billabongAFS/windlogger_digital/README.md

# windlogger_digital v120 
## ! This is only a copy with notes for futurs improvements !

The windlogger digital board is a arduino like board based on the Atmega 1284p.

This repo is on the version 1.2.0.

Go on the [wiki](https://github.com/netbomo/windlogger_digital/wiki) for more information.

## BLOCK DIAGRAM

todo

## RENDER PREVIEW
todo
