billabongAFS/windlogger_digital/Documents/Notice soudure.odt

Ordre des fonctions à souder :

Feuille Power Supply :

- alim 5 Volt, test avec alim externe DC + voltmètre

- alim 3,3V, test avec alim dc externe + voltmètre, erreur pin du mcp1700 inversé (corrigé sur schéma)

- cablage switch supply (usb to 5V) test avec alim et voltmètre

-soudure module uart, test alim par usb, cable usb to microUSB + voltmètre

Feuille microC

- tout souder sauf micro, tester les alim du micro puis le souder

Feuille digital

tout souder

test chargement bootloader par isp :

Attention, si micro atmega1284 et non atmega1284p, éditer dans arduino-1.6.3/hardware/tools/avr/etc (faire une copie avant)

le ficher : avrdude.conf, éditer la section Atmega1284P (ctrl-f) et changer la signature 0x1e 0x97 0x05; par 0x1e 0x97 0x06;

puis upload firmware test_carte (à faire) la led doit clignoter

Monter carte SHIELD et suivre procédure TEST_CARTE

Monter le module de sortie de son choix plus les compo qui vont avec.

Upload firmware datalogger
