billabongAFS/windlogger_digital/Documents/images/sch_anemo_hall.png

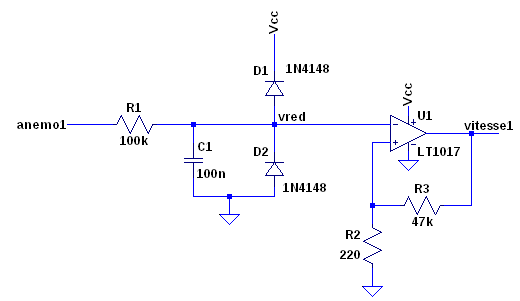
Documents/images/sch_anemo_hall.png
