billabongAFS/windlogger_digital/Documents/images/sch_GPRS.png

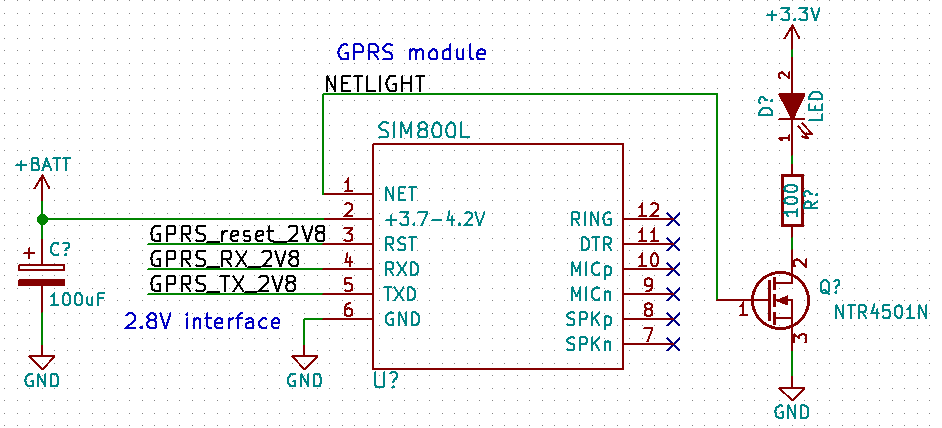
Documents/images/sch_GPRS.png
