billabongAFS/windlogger_digital/Documents/images/sch_huzzah.png

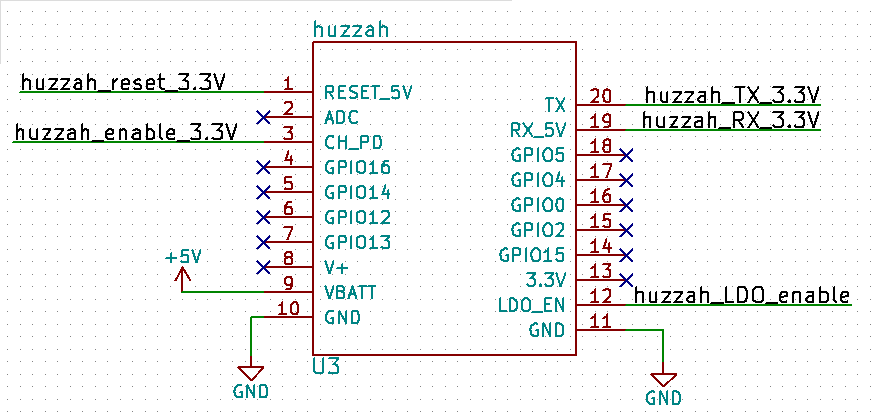
Documents/images/sch_huzzah.png
