billabongAFS/windlogger_digital/Documents/images/sch_RFM69CW.png

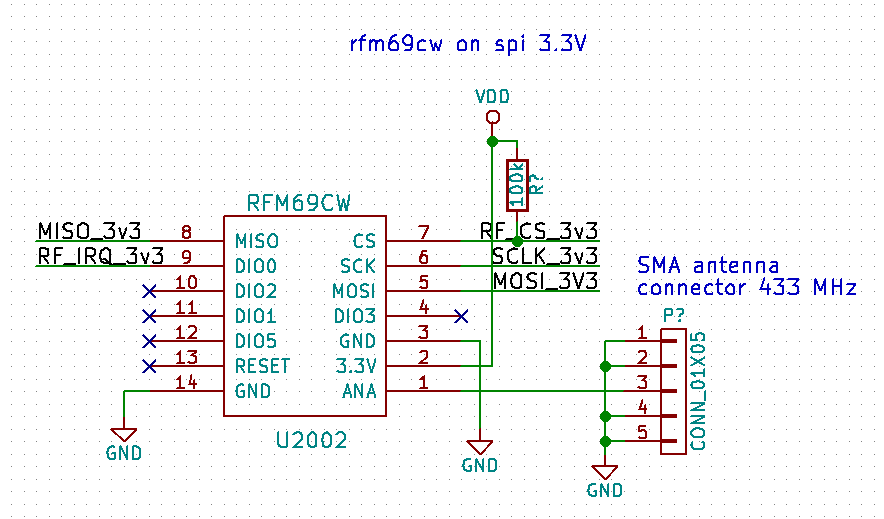
Documents/images/sch_RFM69CW.png
