billabongAFS/windlogger_digital/Documents/images/sch_SD.png

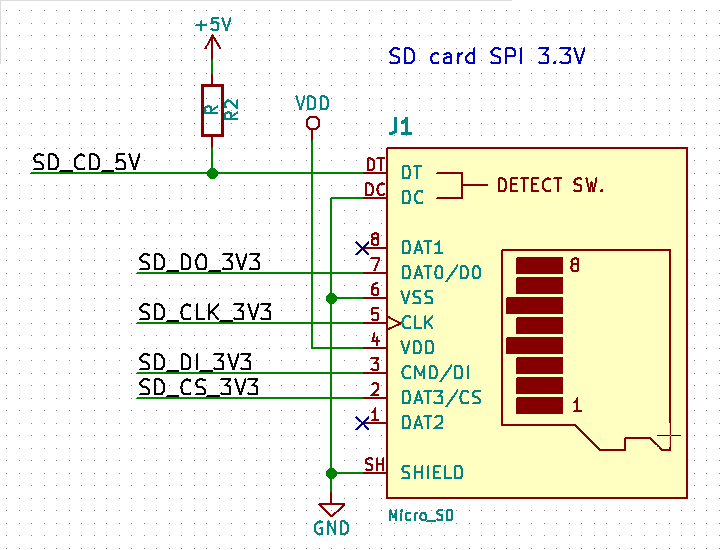
Documents/images/sch_SD.png
