billabongAFS/windlogger_digital/Documents/images/sch_vdc.png

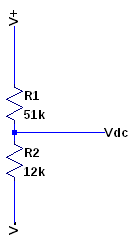
Documents/images/sch_vdc.png
