billabongAFS/windlogger_digital/LTSpice/power_switch.asc

C1: cap; 1µ
M1: pmos; IRF7210
M2: pmos; IRF7210
R1: res; 250
R2: res; 10k
R3: res; 10k
U1: LT1218
V1: voltage; 5
V2: voltage; PULSE(0 5 0 0 0 1 2 5)
V3: voltage; 5
Named nets: 0, cmd, Vbatt, Vmicro, V5V, cmd_inv
.tran 5
