billabongAFS/windlogger_digital/kicad/digital.sch

## KiCad design kicad/digital.sch (2018-02-15)

Schematic: digital.sch

Parts:
Analog1: CONN_01X08; Socket_Strip_Straight_1x08
C1: 100n; C_Rect_L7_W2.5_P5
Communication1: CONN_01X08; Socket_Strip_Straight_1x08
D1: Led_Small; LED-3MM
P1: USART0; uart_usb_cp2102_module
P3: ISP; Socket_Strip_Straight_2x03
P5, P6, P8, P9: hole; MountingHole_3-5mm
POWER_SOURCE1: CONN_01X04; Socket_Strip_Straight_1x04
PWM1: CONN_01X10; Socket_Strip_Straight_1x10
PWM2: CONN_01X08; Socket_Strip_Straight_1x08
Power1: CONN_01X08; Socket_Strip_Straight_1x08
R1: 270; Resistor_Horizontal_RM10mm

Notes on the sheet:
mecanic holes
Arduino style but with Atmega 1284P
Microcontroler Uart to USB bridge
Uac
Udir
Udc
speed1
speed2
1_wire_PWR
1_wire_data
FTDI
RPM
3.3V not connected
+5V GND TX0 RX0 DTR 3V3
ajouter le rtc + pile sur la carte
agrandirles pastilles de trous traversants
