billabongAFS/windlogger_digital/kicad/microC.sch

## KiCad design kicad/microC.sch (2018-02-15)

Schematic: microC.sch

Parts:
C2, C3: 18p; C_Rect_L4_W2.5_P2.5
C4, C5, C6: 100n; C_Rect_L7_W2.5_P5
IC1: ATMEGA1284P-P; DIP-40_W15.24mm_LongPads
R2: 470k; Resistor_Horizontal_RM10mm
SW1: button-touch-6x6mm
X1: 16M; Crystal_HC49-U_Vertical

Notes on the sheet:
Main crystal
Reset button
ajouter une pile avec une comparateur pour isoler le micro lorsqu'aucune source d'alimentation n'est disponible pour que le rtc continue à tourner
