billabongAFS/windlogger_digital/kicad/output.sch

## KiCad design kicad/output.sch (2018-01-26)

Schematic: output.sch

Parts:
C9, C21: 100n; C_Rect_L7_W2.5_P5
D2: Led_Small; LED-3MM
J1: CONN-SMA-5-1814400-1; conn-SMA_TE-5-1814400-1
J2: Micro_SD; HIROSE-MICROSD-DM3AT-SF
Mod1: SIM800L; GPRS-SIM80L-smaller
Mod2: RFM69CW
Mod3: huzzah; adafruit-huzzah
Q1: NTR4501N; SOT-23_Handsoldering
R3: 270; Resistor_Horizontal_RM10mm
R4, R8: 100k; Resistor_Horizontal_RM10mm
R9: 470k; Resistor_Horizontal_RM10mm
U1: 74HC4050; SOIC-16_3.9x9.9mm_Pitch1.27mm

Notes on the sheet:
Radio module : rfm69cw
Huzzah esp connector 5V level tolerent
GPRS module
SD card connector
3.3V tolerance
SMA antenna connector 433 MHz
MCU to outputs levels shifter
UART Modules
SPI modules
