billabongAFS/windlogger_digital/kicad/power_supply.sch

## KiCad design kicad/power_supply.sch (2018-02-15)

Schematic: power_supply.sch

Parts:
C10, C11: 1u; C_Radial_D5_L6_P2.5
C12, C22: 100n; C_Rect_L7_W2.5_P5
C13: 10n; C_Rect_L7_W2.5_P5
C14, C15, C16, C17: 120u; condensator_horizontal_8_11_5
C18, C19: 100nF; C_Rect_L7_W2.5_P5
D3, D5: MBRS540T3G; SMC_Handsoldering
D8: SR5100; Diode_DO-27_Horizontal_RM12
D9: BZX79-C4V7,113; Diode_DO-35_SOD27_Horizontal_RM10
L1: 47u; inductance_murata_1200LRS
P2: CONN_01X03; Pin_Header_Angled_1x03
Q2: NDT2955; SOT-223
R10: 10k; Resistor_Horizontal_RM10mm
S1, S2, S4: CONN_SOLDERABLE
U2: MCP1700; TO-92_Horizontal1_Inline_Narrow_Oval
U7: LM2672M-5.0; SOIC-8_3.9x4.9mm_Pitch1.27mm
U8: LM358; SOIC-8_3.9x4.9mm_Pitch1.27mm
W1: Vin; Measurement_Point_Square-TH_Big
W2: USBVCC; Measurement_Point_Square-TH_Big
W3: +5V; Measurement_Point_Square-TH_Big
W4: +3.3V; Measurement_Point_Square-TH_Big
W5: +BATT; Measurement_Point_Square-TH_Big
W6: GNDPWR; Measurement_Point_Square-TH_Big
W7: GND; Measurement_Point_Square-TH_Big

Notes on the sheet:
DC-DC converter Vin 8 to 40V Vout 5V
5 to 4.1V, 2 A, mount it when use the GPRS sim 800L module
From shield PCB
Jumper to select : UDC or UAC source
DC linear regulator for 3.3V supply
Auto switch, if if Vin is set, don't use +5V from USB
DESCRIPTION: These jumpers allow the isolation of the feeder. To be used during the test phase.
JUMPER CONNECTORS
TESTING PINS
VERY IMPORTANT: This pins can be used to implement testing probes.
passer en CMS pour la diode
ajouter un point test
le 3v3 doit toujours être présent donc plutot séparer l'alim seulement pour le hacheur 5V ajouter un connecteur 5V pour alim direct
changer l'empreinte
