billabongAFS/windlogger_digital/(commit log)

2018-01-26 copy from old repo/branch organisation
    [BOM_digital_1_1_1.ods, digital.sch, microC.sch, output.sch, power_supply.sch]
2018-01-26 initial commit from old repo/branch copy
    [BOM_digital_1_1_1.ods, digital.sch, microC.sch, output.sch, power_supply.sch]
2018-02-09 add somes notes on schematics
    [digital.sch, power_supply.sch]
2018-02-11 change D3 and D5 for smd diode
    [power_supply.sch]
2018-02-15 Modify micro pins and unify ground in power supply
    [digital.sch, microC.sch, power_supply.sch]
