billabongAFS/windlogger_digital/(notices)

Notices in the files:
kicad/output.sch:
AGPL3
